carlosbanda01/Proyecto-Planta-de-monitoreo-climatico/Codigos/scada/IMAGEN/central.jpg

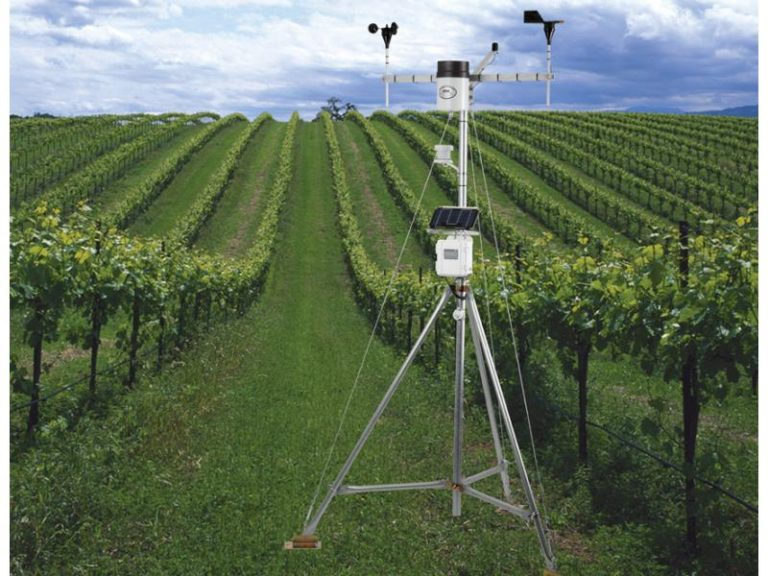
Codigos/scada/IMAGEN/central.jpg
