carlosbanda01/Proyecto-Planta-de-monitoreo-climatico/Codigos/scada/IMAGEN/maqueta.jpg

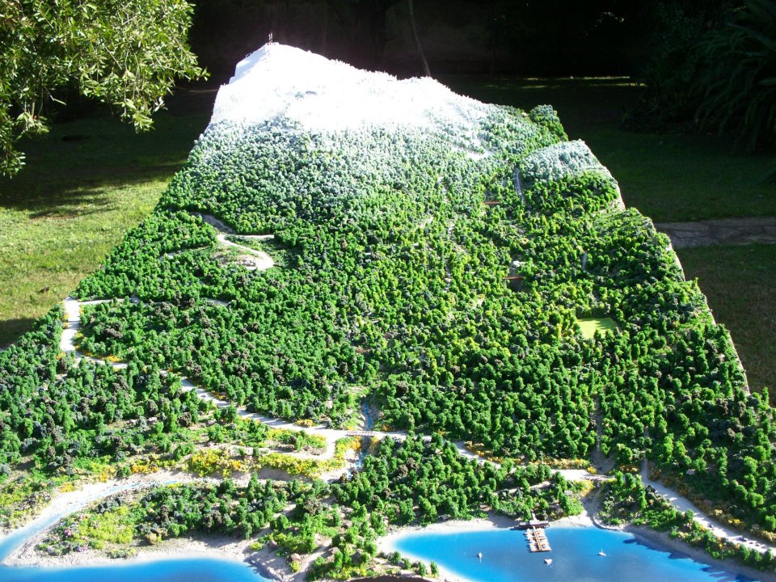
Codigos/scada/IMAGEN/maqueta.jpg
