carlosbanda01/Proyecto-Planta-de-monitoreo-climatico/README.md

# Proyecto-Planta-de-monitoreo-climatico
Proyecto universitario orientado al diseño y construcción de instrumentos de medición electrónica, abarcando todo el ciclo de desarrollo: fabricación de piezas con filamento ABS, diseño y ensamblaje de placas electrónicas, integración en una estructura mecánica y programación del sistema para su funcionamiento autónomo y preciso.
