carlosbanda01/Proyecto-Planta-de-monitoreo-climatico/THIRD_PARTY_LICENSE.md

## Créditos y Atribuciones

- **Modelos 3D originales**  
  - Giovanni Aggiustatutto — "Pluviometer design " ([https://www.instructables.com/DIY-Arduino-Rain-Gauge/])
  - Licencia: [Attribution-NonCommercial-ShareAlike 4.0 International]
