carlosbanda01/Proyecto-Planta-de-monitoreo-climatico/Codigos/scada/IMAGEN/bomba.jpg

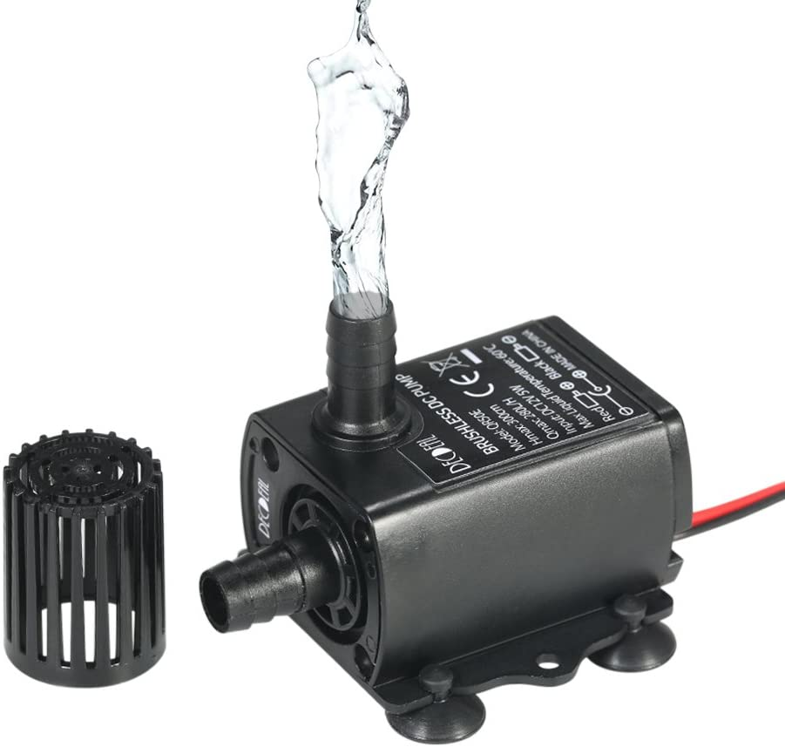
Codigos/scada/IMAGEN/bomba.jpg
