carlosbanda01/Proyecto-Planta-de-monitoreo-climatico/Diseños PCB/alimentacion.pdf

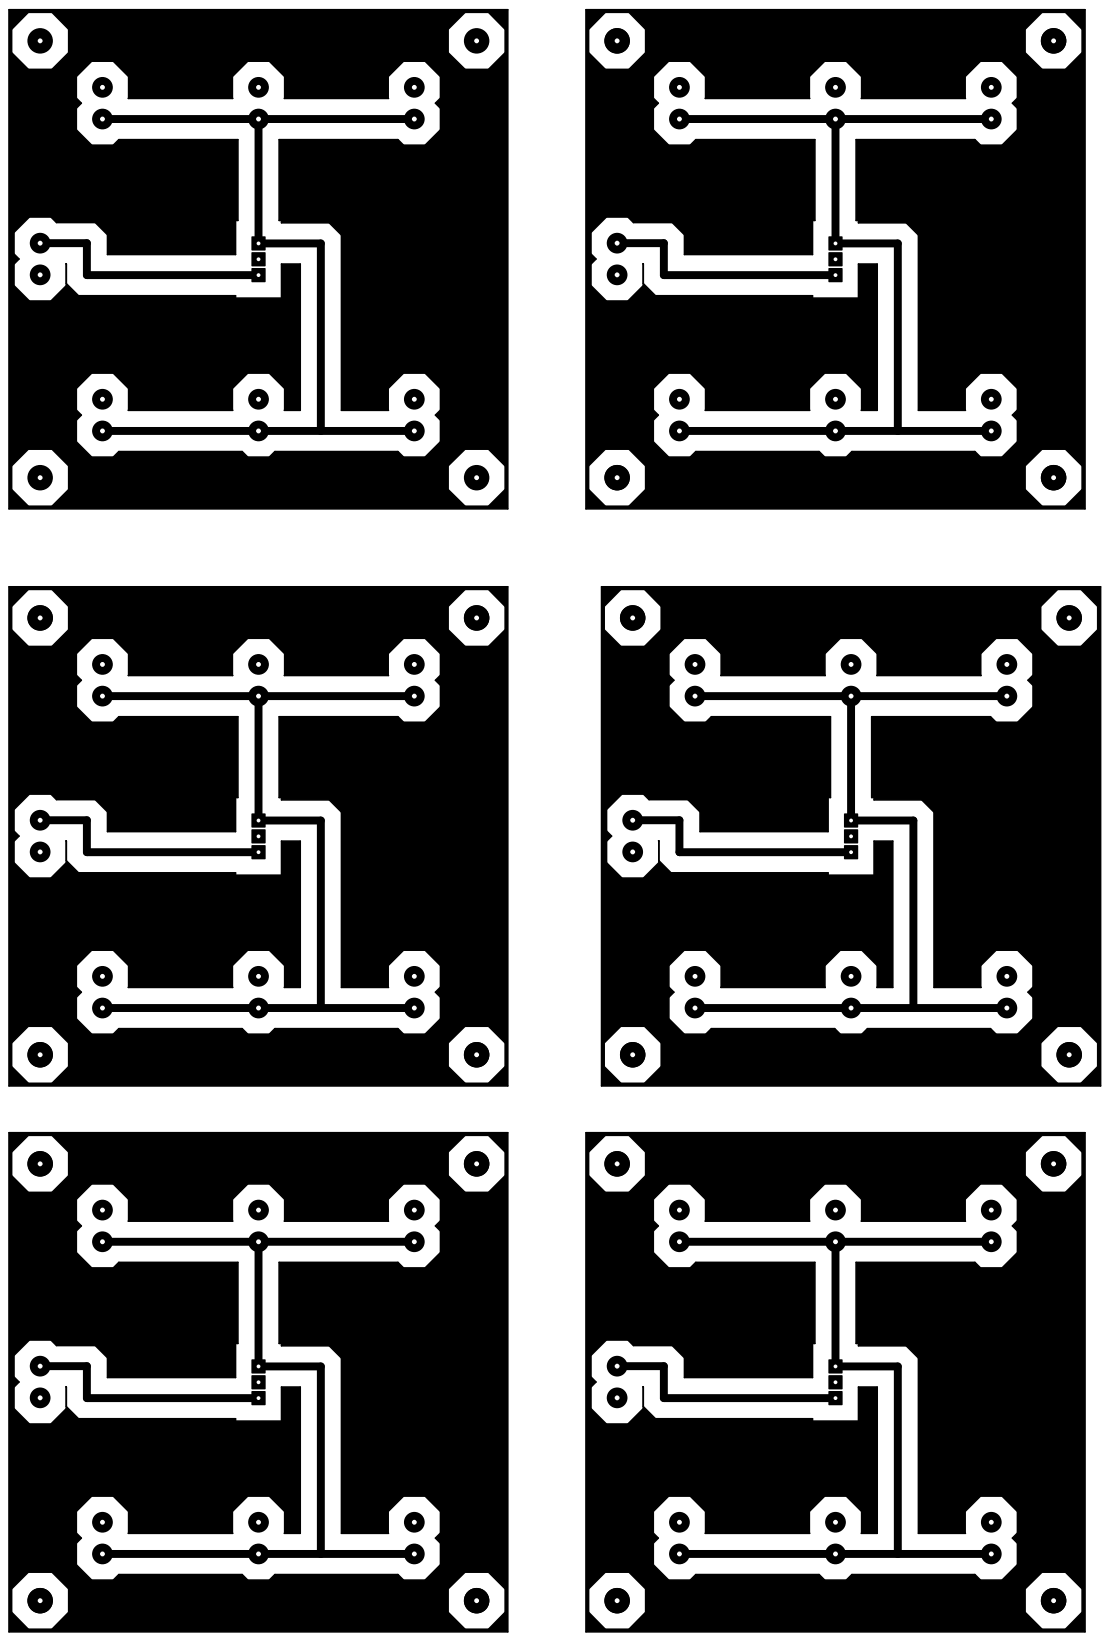
[picture p39: page 1]
