carlosbanda01/Proyecto-Planta-de-monitoreo-climatico/Diseños PCB/maestro.pdf

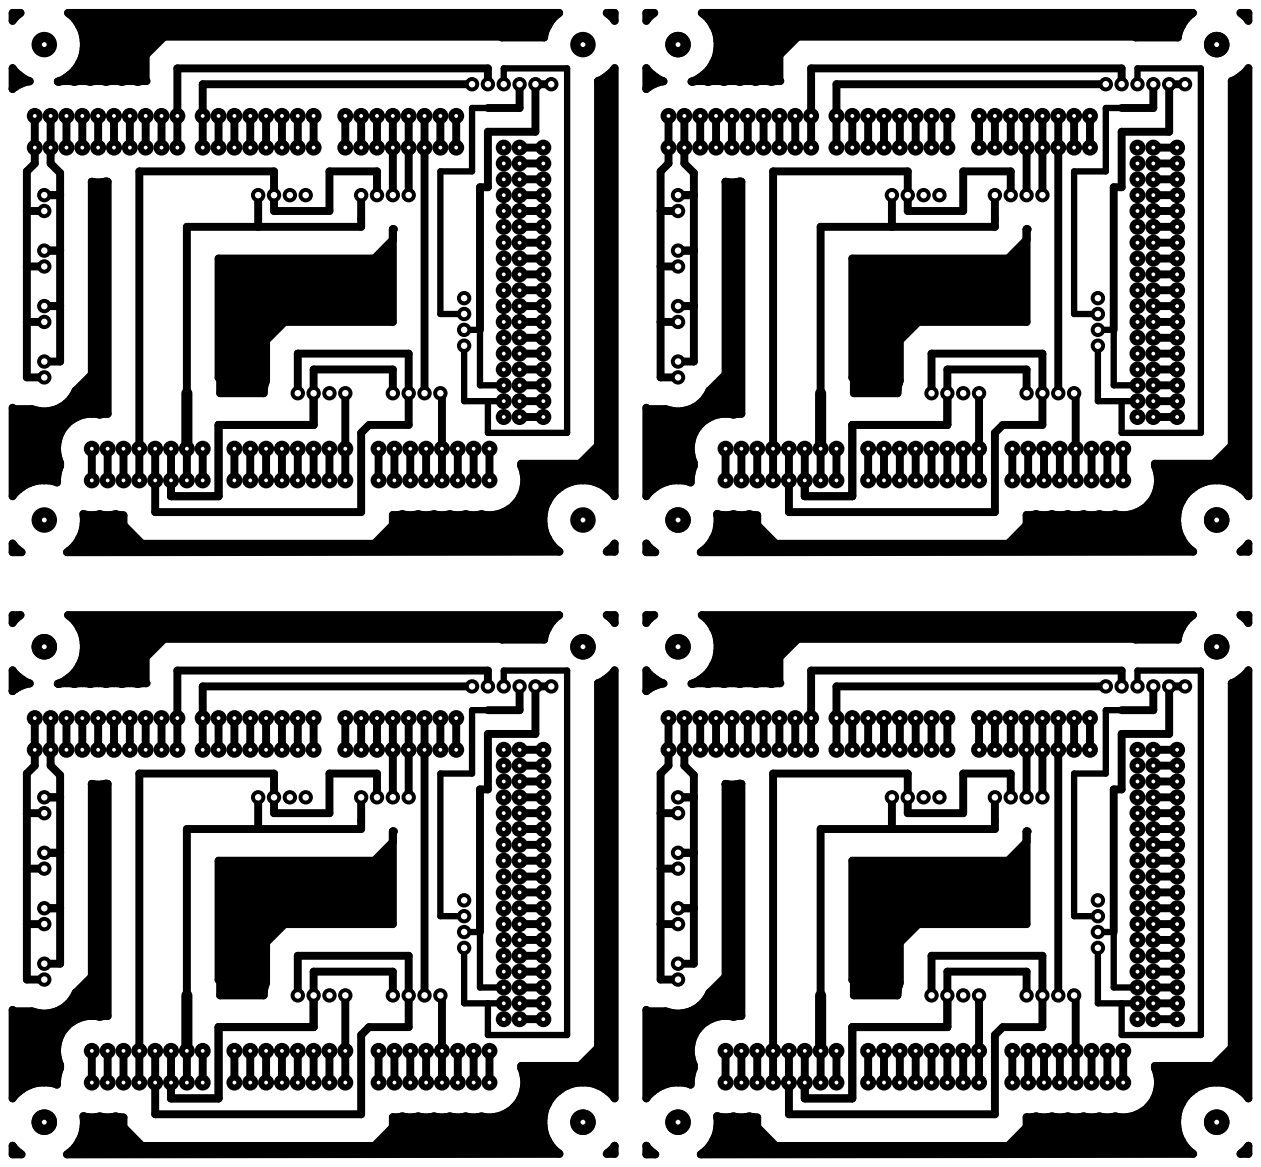
[picture p40: page 1]
