carlosbanda01/Proyecto-Planta-de-monitoreo-climatico/Diseños PCB/mestro_completo.pdf

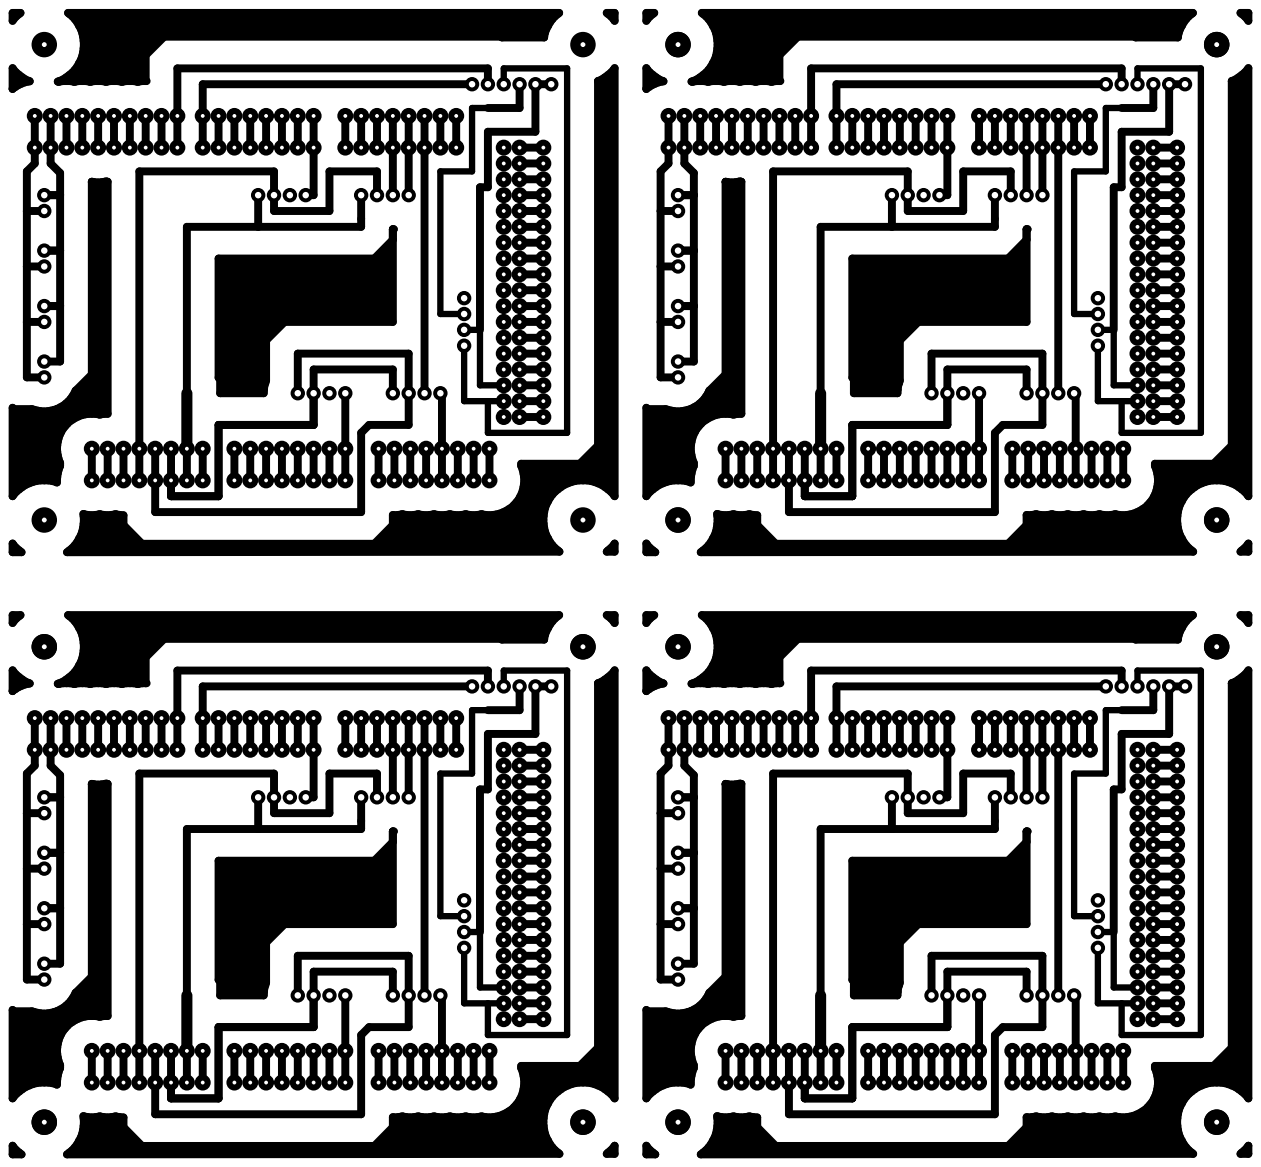
[picture p41: page 1]
