carlosbanda01/Proyecto-Planta-de-monitoreo-climatico/Diseños PCB/pantalla_placa.pdf

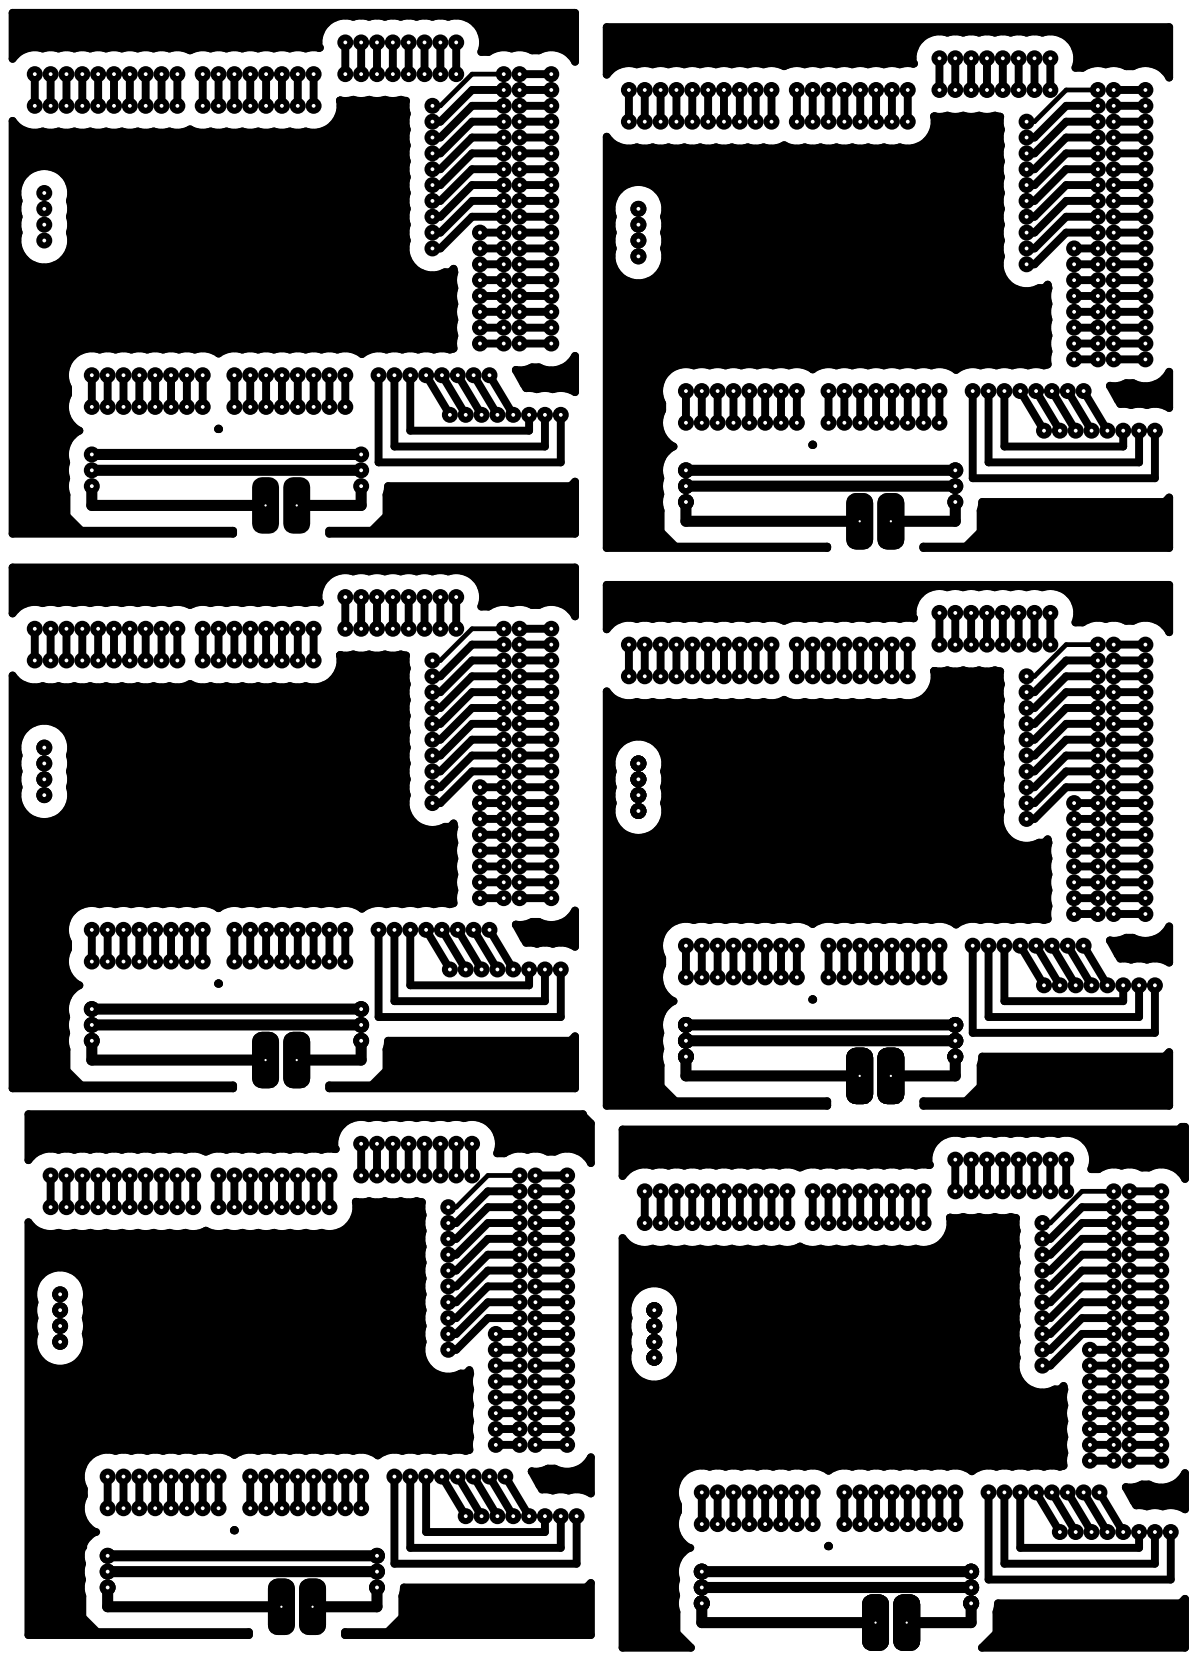
[picture p42: page 1]
